nsarrault96/EFM32TG11-Core/README.md

# Kicad Project Template

This is a simple kicad project template designed to use submodules for any additional pieces including libraries,
firmware/software and CAD design.
