nsarrault96/EFM32TG11-Core/pcb/EFM32TG11-Core.kicad_pcb

## KiCad design pcb/EFM32TG11-Core.kicad_pcb (2022-02-25)

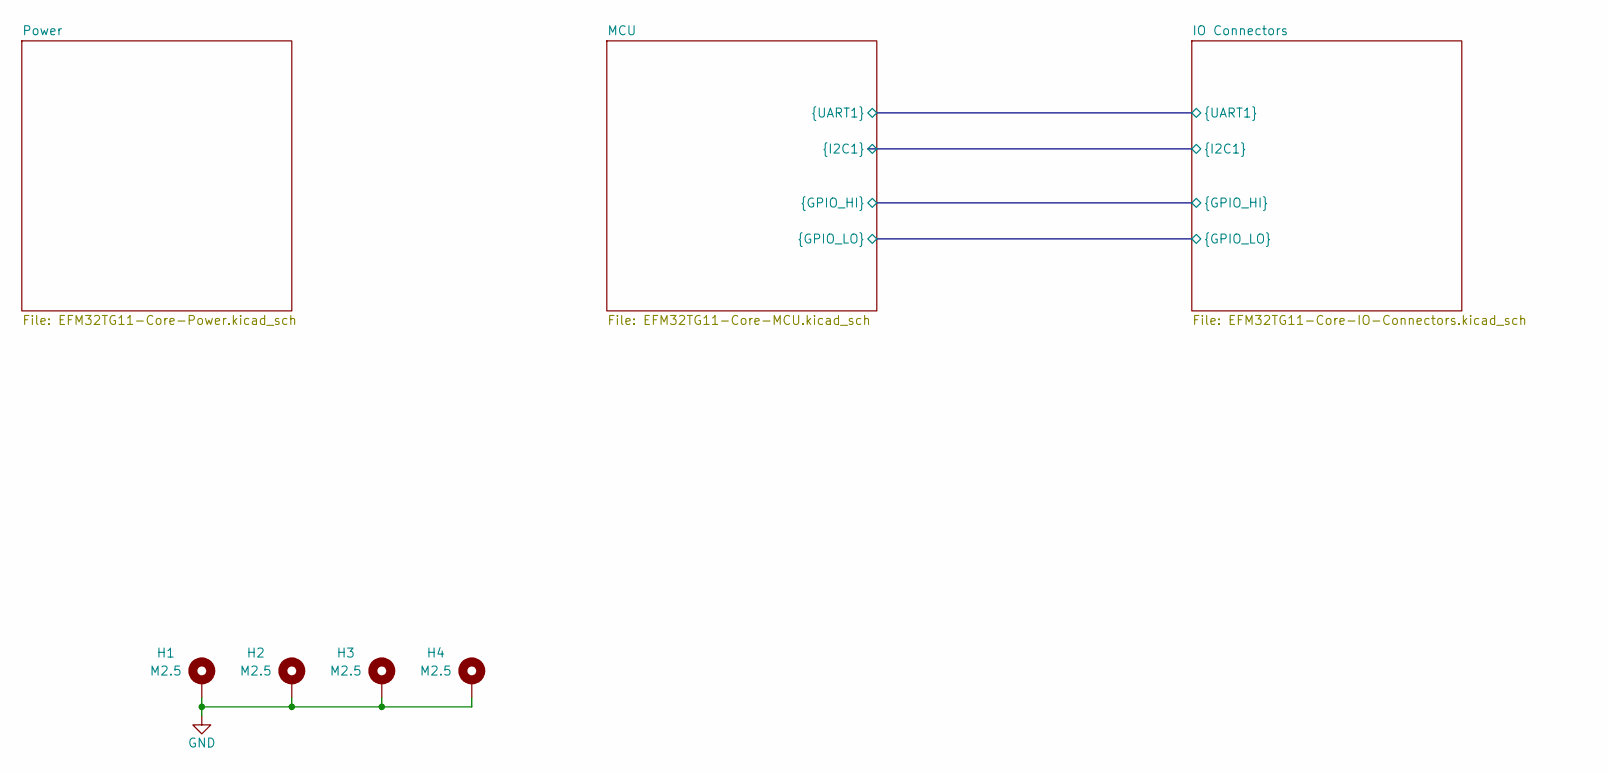
[picture p1: schematic EFM32TG11-Core.kicad_sch]

Parts:
H1, H2, H3, H4: M2.5; MountingHole_2.7mm_M2.5_Pad

Connections:
GND: H1.1, H2.1, H3.1, H4.1; also elsewhere on the board

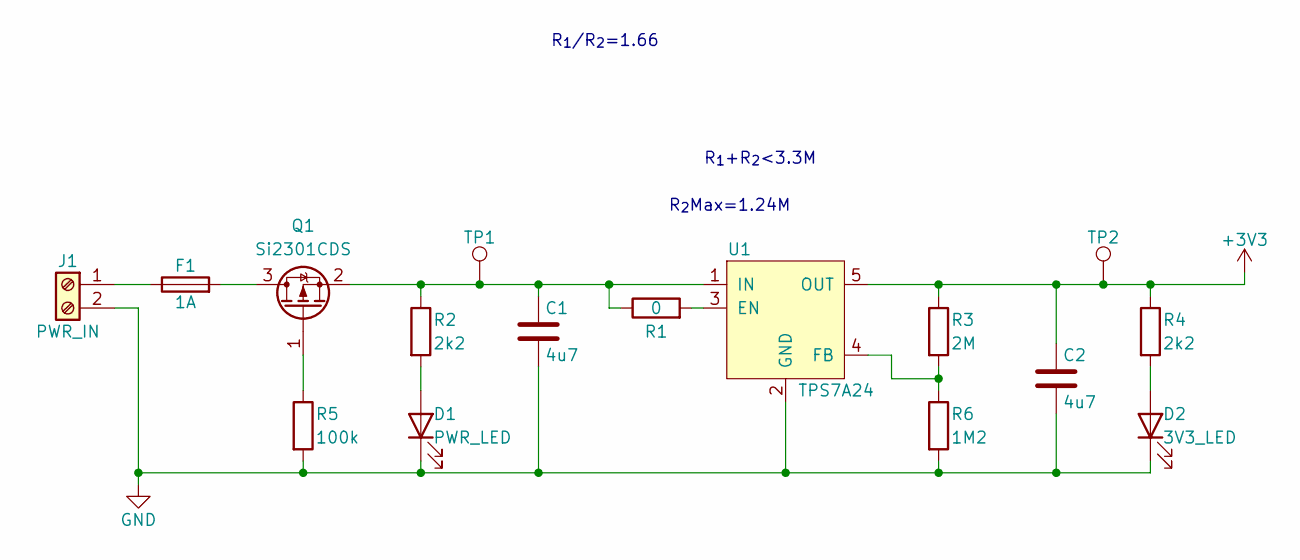
[picture p2: schematic EFM32TG11-Core-Power.kicad_sch, EFM32TG11-Core]

Parts:
C1, C2: 4u7; C_0805_2012Metric; PartsBox PN CAP-0805-4u7-X7R-25V
D1: PWR_LED; D_0603_1608Metric_Pad1.05x0.95mm_HandSolder; PartsBox PN LTST-C191KRKT
D2: 3V3_LED; D_0603_1608Metric_Pad1.05x0.95mm_HandSolder; PartsBox PN LTST-C191KRKT
F1: 1A; Fuse_0603_1608Metric; PartsBox PN 0686F1000-01
J1: PWR_IN; TerminalBlock_Phoenix_PT-1,5-2-3.5-H_1x02_P3.50mm_Horizontal; PartsBox PN 1984617
Q1: Si2301CDS; SOT-23; PartsBox PN SI2301CDS-T1-GE3
R1: 0; R_0603_1608Metric; PartsBox PN RES-0603-0R-0.1W
R2, R4: 2k2; R_0603_1608Metric; PartsBox PN RES-0603-2k2-0.1W
R3: 2M; R_0603_1608Metric; PartsBox PN RES-0603-2M-0.1W
R5: 100k; R_0603_1608Metric; PartsBox PN RES-0603-100k-0.1W
R6: 1M2; R_0603_1608Metric; PartsBox PN RES-0603-1M2-0.1W
TP1, TP2: TestPoint; TestPoint_Pad_D1.0mm
U1: TPS7A24; SOT-23-5; PartsBox PN TPS7A2401DBVR

Connections:
+3V3: C2.1, R3.1, R4.1, TP2.1, U1.5 (OUT); also elsewhere on the board
GND: C1.2, C2.2, D1.1 (K), D2.1 (K), J1.2, R5.2, R6.2, U1.2 (GND); also elsewhere on the board
unnamed: C1.1, Q1.2 (S), R1.1, R2.1, TP1.1, U1.1 (IN)
unnamed: D1.2 (A), R2.2
unnamed: D2.2 (A), R4.2
unnamed: F1.1, J1.1
unnamed: F1.2, Q1.3 (D)
unnamed: Q1.1 (G), R5.1
unnamed: R1.2, U1.3 (EN)
unnamed: R3.2, R6.1, U1.4 (FB)

Notes on the sheet:
R_{2}Max=1.24M
R_{1}/R_{2}=1.66
R_{1}+R_{2}<3.3M

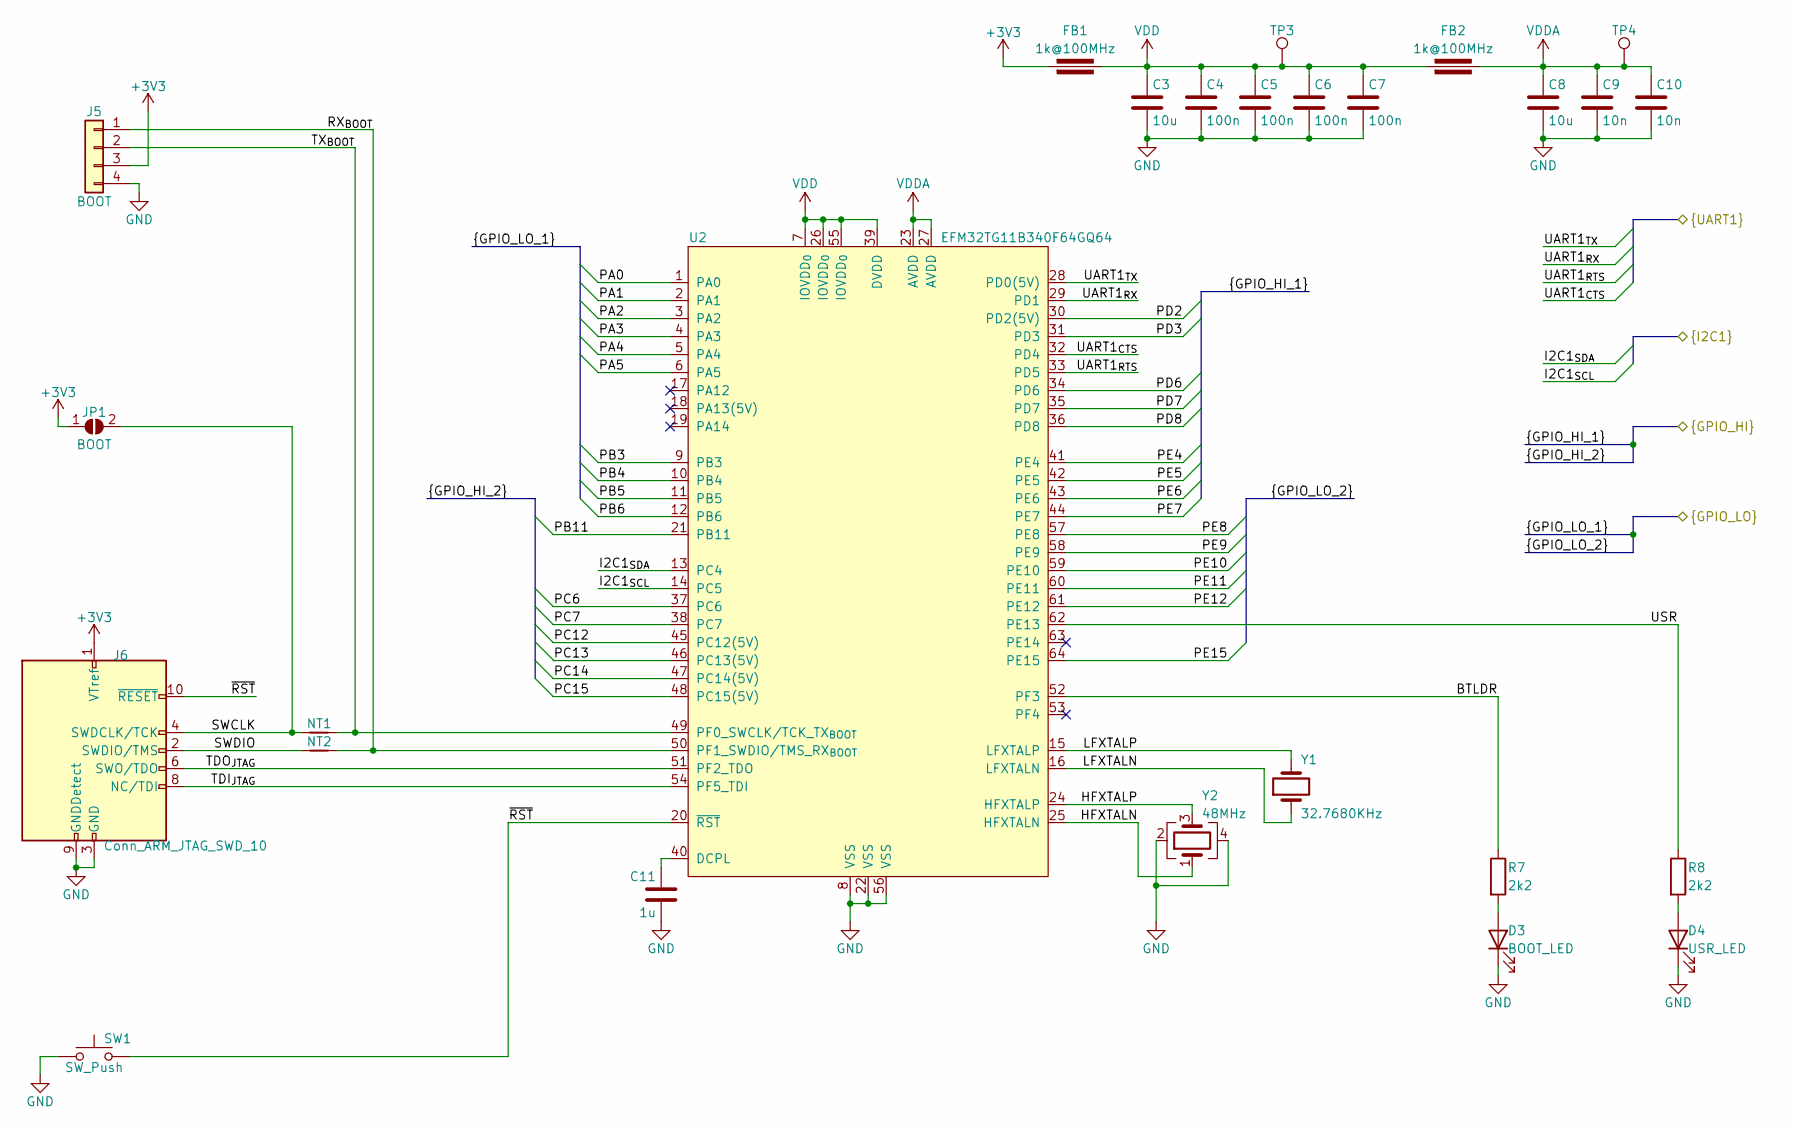
[picture p3: schematic EFM32TG11-Core-MCU.kicad_sch, EFM32TG11-Core]

Parts:
C3, C8: 10u; C_1206_3216Metric; PartsBox PN CAP-1206-10u-X7R-25V
C4, C5, C6, C7: 100n; C_0603_1608Metric; PartsBox PN CAP-0603-100n-X7R-50V
C9, C10: 10n; C_0603_1608Metric; PartsBox PN CAP-0603-10n-X7R-50V
C11: 1u; C_0603_1608Metric; PartsBox PN CAP-0603-1u-X7R-25V
D3: BOOT_LED; D_0603_1608Metric_Pad1.05x0.95mm_HandSolder; PartsBox PN LTST-C191KFKT
D4: USR_LED; D_0603_1608Metric_Pad1.05x0.95mm_HandSolder; PartsBox PN LTST-C191KFKT
FB1, FB2: 1k@100MHz; L_0603_1608Metric; PartsBox PN BLM18KG102SN1D
J5: BOOT; PinHeader_1x04_P2.54mm_Horizontal
J6: Conn_ARM_JTAG_SWD_10; PinHeader_2x05_P1.27mm_Vertical
JP1: BOOT; SolderJumper-2_P1.3mm_Open_RoundedPad1.0x1.5mm
NT1, NT2: NetTie_2; NetTie-2_THT_Pad0.3mm
R7, R8: 2k2; R_0603_1608Metric; PartsBox PN RES-0603-2k2-0.1W
SW1: SW_Push; SW_SPST_CK_RS282G05A3; PartsBox PN TS-1101-C-W
TP3, TP4: TestPoint; TestPoint_Pad_D1.0mm
U2: EFM32TG11B340F64GQ64; TQFP-64_10x10mm_P0.5mm; PartsBox PN EFM32TG11B340F64GQ64-A
Y1: 32.7680KHz; Crystal_SMD_MicroCrystal_CC7V-T1A-2Pin_3.2x1.5mm; PartsBox PN FC-135 32.7680KA-AG5
Y2: 48MHz; Crystal_SMD_2016-4Pin_2.0x1.6mm; PartsBox PN 7D048000I01

Connections:
+3V3: FB1.1, J5.3, J6.1 (VTref), JP1.1 (A); also elsewhere on the board
/IO Connectors/UART1_{CTS}: U2.32 (PD4); also elsewhere on the board
/IO Connectors/UART1_{RTS}: U2.33 (PD5); also elsewhere on the board
/IO Connectors/UART1_{RX}: U2.29 (PD1); also elsewhere on the board
/IO Connectors/UART1_{TX}: U2.28 (PD0(5V)); also elsewhere on the board
/MCU/BTLDR: R7.1, U2.52 (PF3)
/MCU/HFXTALN: U2.25 (HFXTALN), Y2.1
/MCU/HFXTALP: U2.24 (HFXTALP), Y2.3
/MCU/I2C1_{SCL}: U2.14 (PC5)
/MCU/I2C1_{SDA}: U2.13 (PC4)
/MCU/LFXTALN: U2.16 (LFXTALN), Y1.1
/MCU/LFXTALP: U2.15 (LFXTALP), Y1.2
/MCU/PA0: U2.1 (PA0)
/MCU/PA1: U2.2 (PA1)
/MCU/PA2: U2.3 (PA2)
/MCU/PA3: U2.4 (PA3)
/MCU/PA4: U2.5 (PA4)
/MCU/PA5: U2.6 (PA5)
/MCU/PB3: U2.9 (PB3)
/MCU/PB4: U2.10 (PB4)
/MCU/PB5: U2.11 (PB5)
/MCU/PB6: U2.12 (PB6)
/MCU/PB11: U2.21 (PB11)
/MCU/PC6: U2.37 (PC6)
/MCU/PC7: U2.38 (PC7)
/MCU/PC12: U2.45 (PC12(5V))
/MCU/PC13: U2.46 (PC13(5V))
/MCU/PC14: U2.47 (PC14(5V))
/MCU/PC15: U2.48 (PC15(5V))
/MCU/PD2: U2.30 (PD2(5V))
/MCU/PD3: U2.31 (PD3)
/MCU/PD6: U2.34 (PD6)
/MCU/PD7: U2.35 (PD7)
/MCU/PD8: U2.36 (PD8)
/MCU/PE4: U2.41 (PE4)
/MCU/PE5: U2.42 (PE5)
/MCU/PE6: U2.43 (PE6)
/MCU/PE7: U2.44 (PE7)
/MCU/PE8: U2.57 (PE8)
/MCU/PE9: U2.58 (PE9)
/MCU/PE10: U2.59 (PE10)
/MCU/PE11: U2.60 (PE11)
/MCU/PE12: U2.61 (PE12)
/MCU/PE15: U2.64 (PE15)
/MCU/RX_{BOOT}: J5.1, NT2.2, U2.50 (PF1_SWDIO/TMS_RX_{BOOT})
/MCU/SWCLK: J6.4 (SWDCLK/TCK), JP1.2 (B), NT1.1
/MCU/SWDIO: J6.2 (SWDIO/TMS), NT2.1
/MCU/TDI_{JTAG}: J6.8 (NC/TDI), U2.54 (PF5_TDI)
/MCU/TDO_{JTAG}: J6.6 (SWO/TDO), U2.51 (PF2_TDO)
/MCU/TX_{BOOT}: J5.2, NT1.2, U2.49 (PF0_SWCLK/TCK_TX_{BOOT})
/MCU/USR: R8.1, U2.62 (PE13)
/MCU/~RST: J6.10 (~RESET), SW1.2, U2.20 (~RST)
GND: C3.2, C4.2, C5.2, C6.2, C7.2, C8.2, C9.2, C10.2, C11.2, D3.1 (K), D4.1 (K), J5.4, J6.3 (GND), J6.5 (GND), J6.9 (GNDDetect), SW1.1, U2.8 (VSS), U2.22 (VSS), U2.56 (VSS), Y2.2, Y2.4; also elsewhere on the board
unnamed: C11.1, U2.40 (DCPL)
unnamed: D3.2 (A), R7.2
unnamed: D4.2 (A), R8.2
VDD: C3.1, C4.1, C5.1, C6.1, C7.1, FB1.2, FB2.1, TP3.1, U2.7 (IOVDD_{0}), U2.26 (IOVDD_{0}), U2.39 (DVDD), U2.55 (IOVDD_{0})
VDDA: C8.1, C9.1, C10.1, FB2.2, TP4.1, U2.23 (AVDD), U2.27 (AVDD)

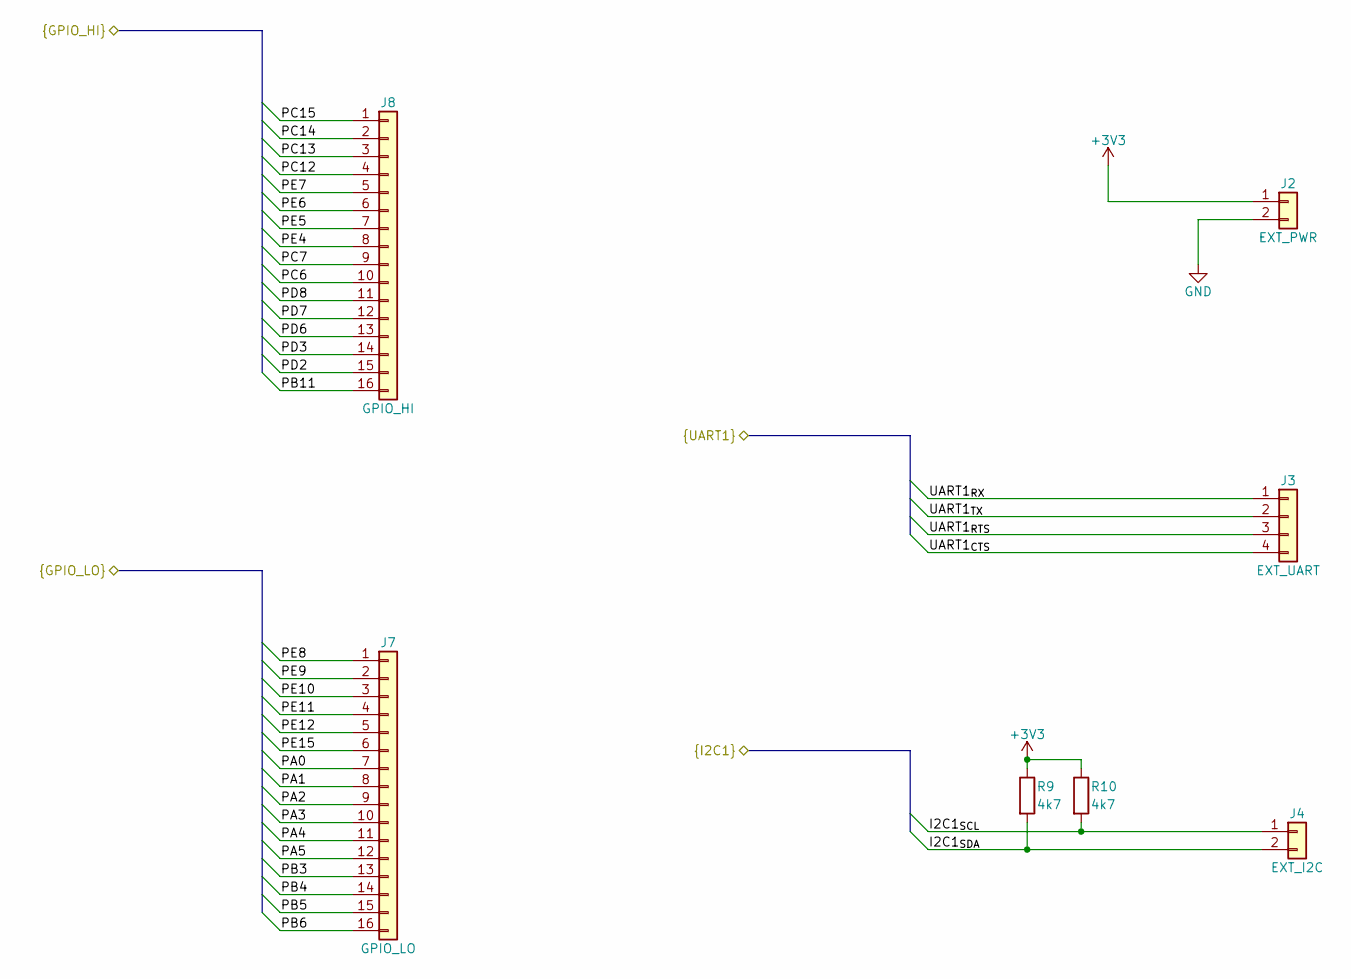
[picture p4: schematic EFM32TG11-Core-IO-Connectors.kicad_sch, EFM32TG11-Core]

Parts:
J2: EXT_PWR; PinHeader_1x02_P2.54mm_Horizontal
J3: EXT_UART; PinHeader_1x04_P2.54mm_Horizontal
J4: EXT_I2C; PinHeader_1x02_P2.54mm_Horizontal
J7: GPIO_LO; PinSocket_1x16_P2.54mm_Vertical
J8: GPIO_HI; PinSocket_1x16_P2.54mm_Vertical
R9, R10: 4k7; R_0603_1608Metric; PartsBox PN RES-0603-4k7-0.1W

Connections:
+3V3: J2.1, R9.1, R10.1; also elsewhere on the board
/IO Connectors/I2C1_{SCL}: J4.1, R10.2
/IO Connectors/I2C1_{SDA}: J4.2, R9.2
/IO Connectors/PA0: J7.7
/IO Connectors/PA1: J7.8
/IO Connectors/PA2: J7.9
/IO Connectors/PA3: J7.10
/IO Connectors/PA4: J7.11
/IO Connectors/PA5: J7.12
/IO Connectors/PB3: J7.13
/IO Connectors/PB4: J7.14
/IO Connectors/PB5: J7.15
/IO Connectors/PB6: J7.16
/IO Connectors/PB11: J8.16
/IO Connectors/PC6: J8.10
/IO Connectors/PC7: J8.9
/IO Connectors/PC12: J8.4
/IO Connectors/PC13: J8.3
/IO Connectors/PC14: J8.2
/IO Connectors/PC15: J8.1
/IO Connectors/PD2: J8.15
/IO Connectors/PD3: J8.14
/IO Connectors/PD6: J8.13
/IO Connectors/PD7: J8.12
/IO Connectors/PD8: J8.11
/IO Connectors/PE4: J8.8
/IO Connectors/PE5: J8.7
/IO Connectors/PE6: J8.6
/IO Connectors/PE7: J8.5
/IO Connectors/PE8: J7.1
/IO Connectors/PE9: J7.2
/IO Connectors/PE10: J7.3
/IO Connectors/PE11: J7.4
/IO Connectors/PE12: J7.5
/IO Connectors/PE15: J7.6
/IO Connectors/UART1_{CTS}: J3.4; also elsewhere on the board
/IO Connectors/UART1_{RTS}: J3.3; also elsewhere on the board
/IO Connectors/UART1_{RX}: J3.1; also elsewhere on the board
/IO Connectors/UART1_{TX}: J3.2; also elsewhere on the board
GND: J2.2; also elsewhere on the board

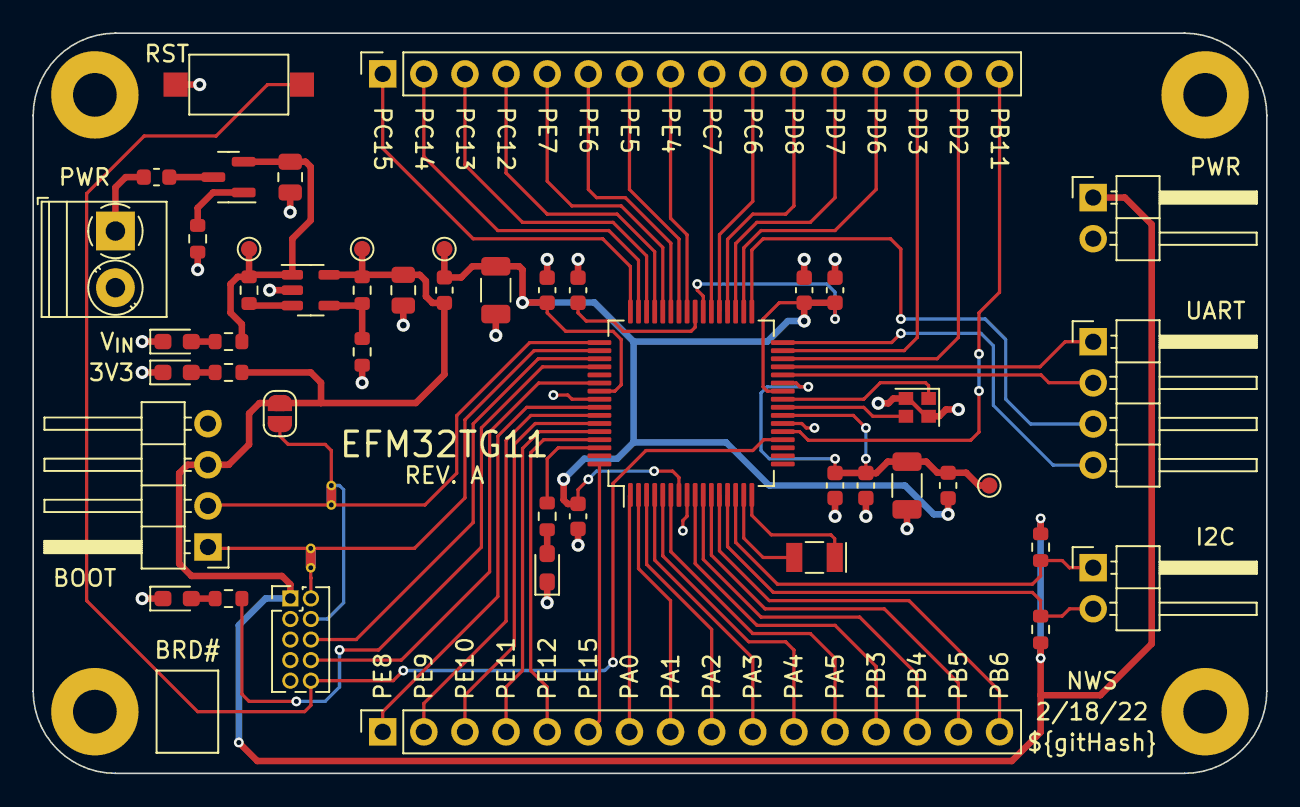
[picture p5: board EFM32TG11-Core.kicad_pcb from above]

Board: 2 copper layers, 76.2 x 45.7 mm, 53 parts (0 on the bottom side), 34 nets.
