nsarrault96/EFM32TG11-Core/(commit log)

2022-02-23 Initial Commit
    Initial commit of the project with revision A of the schematic and
    PCB. As sent to OSHPark on 2/18/2022.
    [EFM32TG11-Core-B_Cu.gbr, EFM32TG11-Core-B_Mask.gbr, EFM32TG11-Core-B_Paste.gbr, EFM32TG11-Core-B_Silkscreen.gbr, EFM32TG11-Core-Edge_Cuts.gbr, EFM32TG11-Core-F_Cu.gbr, EFM32TG11-Core-F_Mask.gbr, EFM32TG11-Core-F_Paste.gbr]
2022-02-24 Reorganization of schematic to heirarchical sheets
    Took single sheet schematic and reorganized to 3 heirarchical sheets.
    This allowed for the schematic to be printable on 8.5"x11" sheets of
    paper without losing clarity of the schematic. All reference
    designators were maintained.
    Buses and interconnects between pages still need to be added to the
    schematic to finish transition.
    [Issue: X]
    [EFM32TG11-Core-IO-Connectors.kicad_sch, EFM32TG11-Core-MCU.kicad_sch, EFM32TG11-Core-Power.kicad_sch, EFM32TG11-Core.kicad_pcb, EFM32TG11-Core.kicad_sch]
2022-02-24 Fix Nets for Hierarchical Sheets
    Defined busses to pass nets to and from MCU sheet and IO connector
    sheet.
    [EFM32TG11-Core-IO-Connectors.kicad_sch, EFM32TG11-Core-MCU.kicad_sch, EFM32TG11-Core.kicad_pcb, EFM32TG11-Core.kicad_sch]
2022-02-25 Added commit hash to schematic and PCB
    Commit hash was added as a text variable to be added to the schematic
    title block and the PCB silkscreen layer. A box with label to record
    the board # was also added to the PCB silkscreen layer.
    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
    [EFM32TG11-Core-IO-Connectors.kicad_sch, EFM32TG11-Core-MCU.kicad_sch, EFM32TG11-Core-Power.kicad_sch, EFM32TG11-Core.kicad_pcb, EFM32TG11-Core.kicad_sch]
2022-02-25 Update clean script for project
    Updated the clean filter to ignore the hash in the project file.
    This allows me to stay up to date with the hash. Otherwise it
    would always be behind.
